Robopoly/m-puck-v2/README.md

# m-puck-v2
m-puck structure updated to fit with the new motors of the kit PRisme
