Robopoly/m-puck-v2/stl (for 3D printing)/prismeHaut2.stl

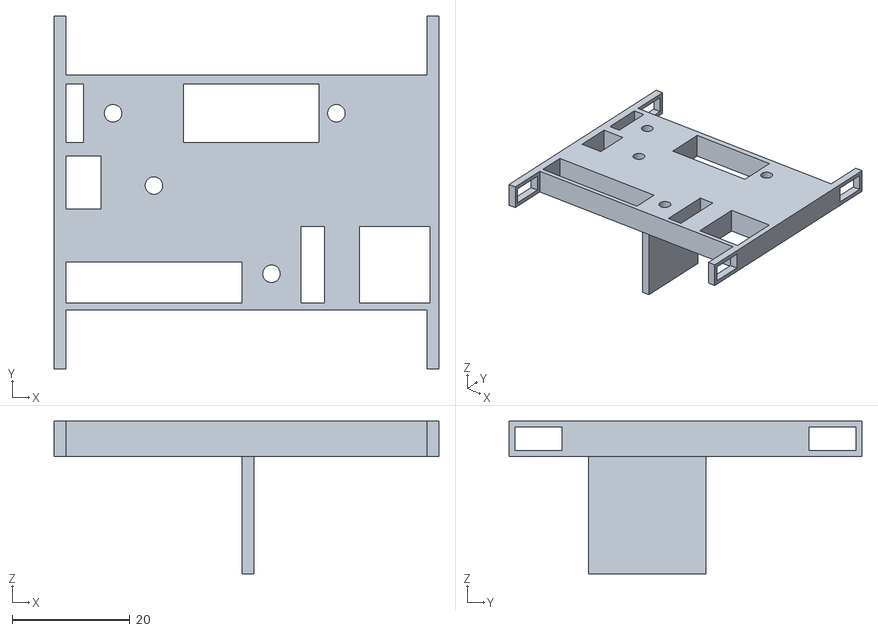
[picture p1: CAD file, 2020-05-28]
stl (for 3D printing)/prismeHaut2.stl
65.5 x 60.0 x 26.0
