Robopoly/m-puck-v2/stp/Prisme_bas.stp

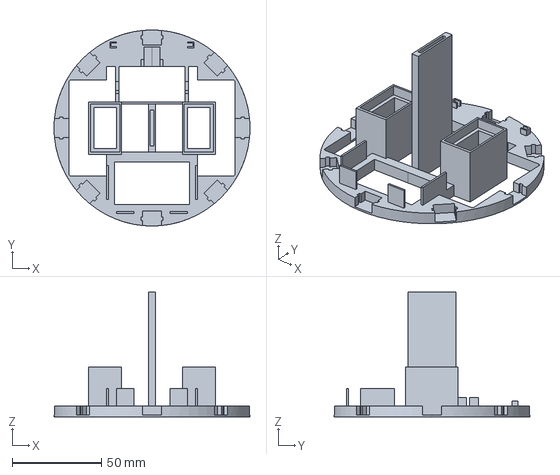
[picture p2: CAD file, 2020-05-28]
stp/Prisme_bas.stp
110.0 x 109.9 x 70.0 mm
