Robopoly/m-puck-v2/stl (for 3D printing)/Prisme_bas.stl

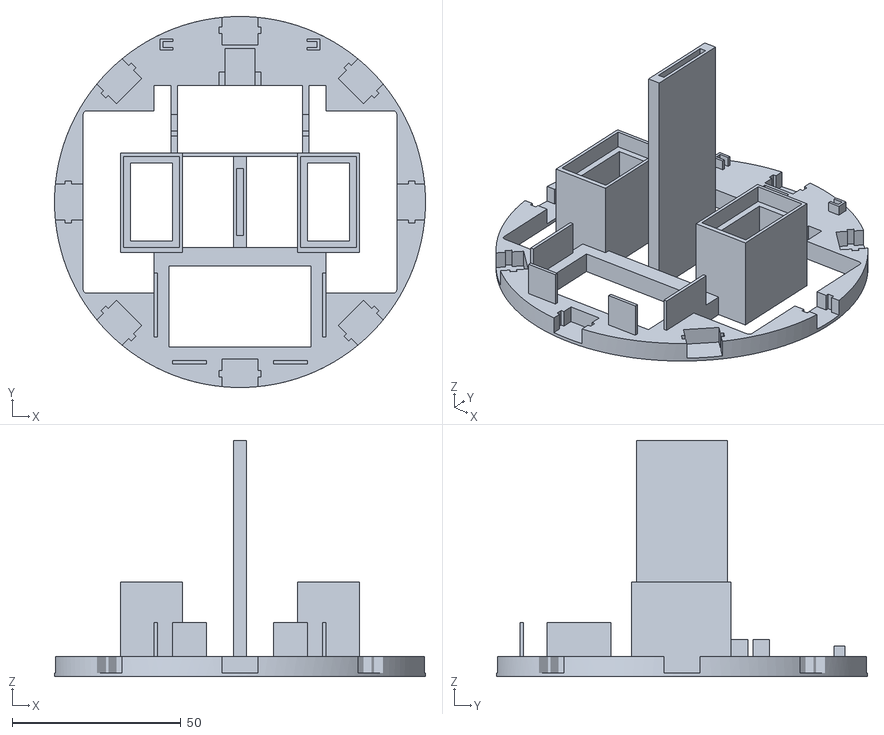
[picture p3: CAD file, 2020-05-28]
stl (for 3D printing)/Prisme_bas.stl
110.0 x 110.0 x 70.0
