Robopoly/m-puck-v2/(list of files, cad)

Other CAD files:
stp/prismeHaut2.stp
CATPart/Prisme_bas.CATPart
CATPart/prismeHaut2.CATPart
